GelSight-lab/GraspEveryThing/hardware/fingers/aloha/one_finger_tactile/one_finger_front_casing.STEP

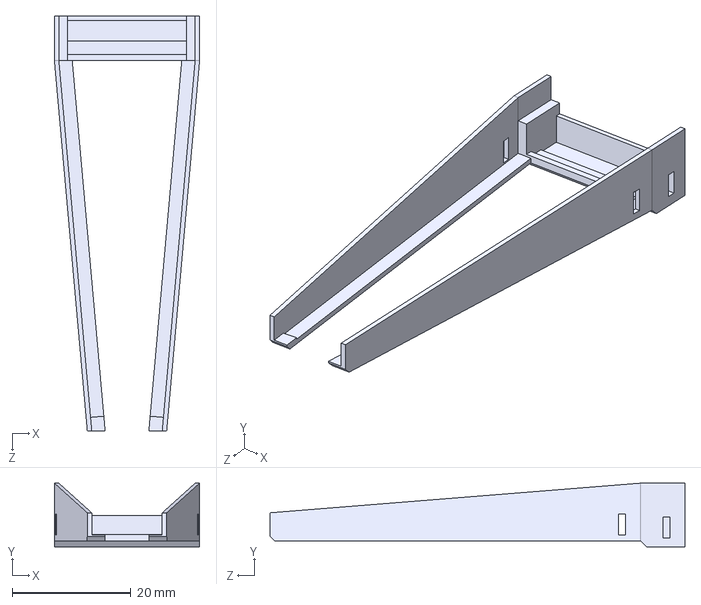
[picture p9: CAD file, 2025-05-14]
hardware/fingers/aloha/one_finger_tactile/one_finger_front_casing.STEP
24.5 x 10.7 x 70.0 mm
