GelSight-lab/GraspEveryThing/hardware/fingers/aloha/two_finger/two_finger.STEP

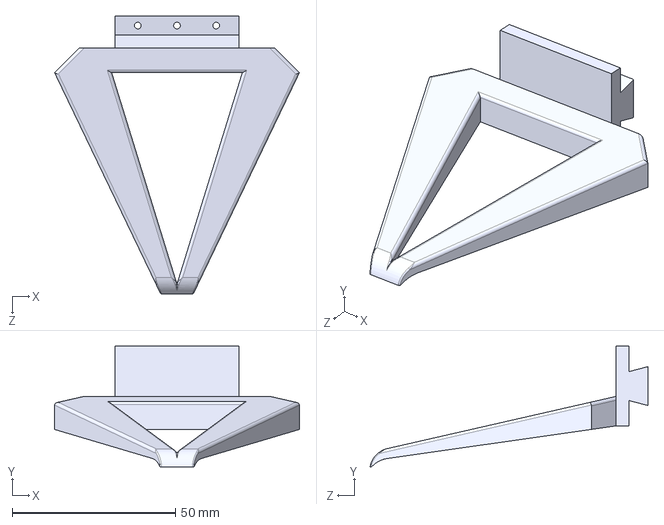
[picture p10: CAD file, 2025-05-14]
hardware/fingers/aloha/two_finger/two_finger.STEP
75.0 x 36.9 x 85.1 mm
