GelSight-lab/GraspEveryThing/hardware/fingers/panda/one_finger_no_tactile/one_finger_backing.STEP

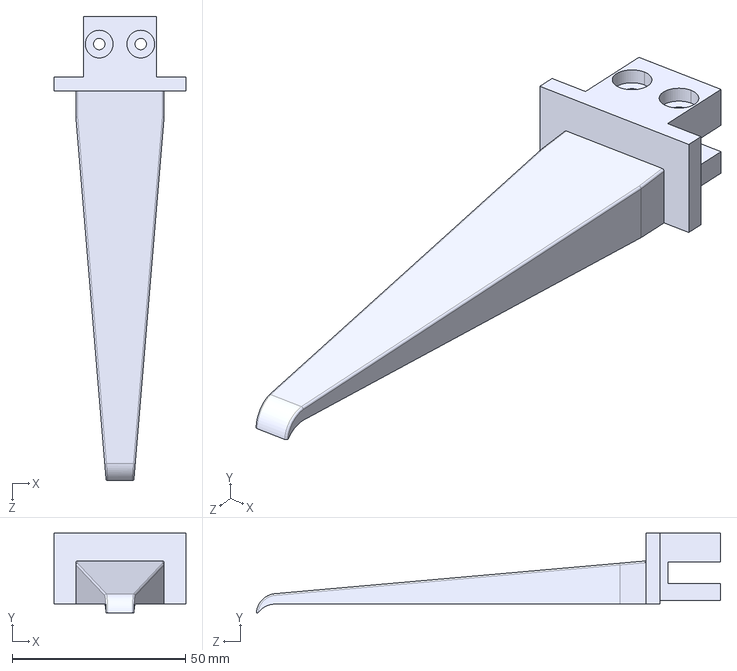
[picture p11: CAD file, 2025-05-14]
hardware/fingers/panda/one_finger_no_tactile/one_finger_backing.STEP
38.1 x 23.0 x 134.0 mm
