GelSight-lab/GraspEveryThing/hardware/fingers/panda/one_finger_tactile/one_finger_camera_stalk.STEP

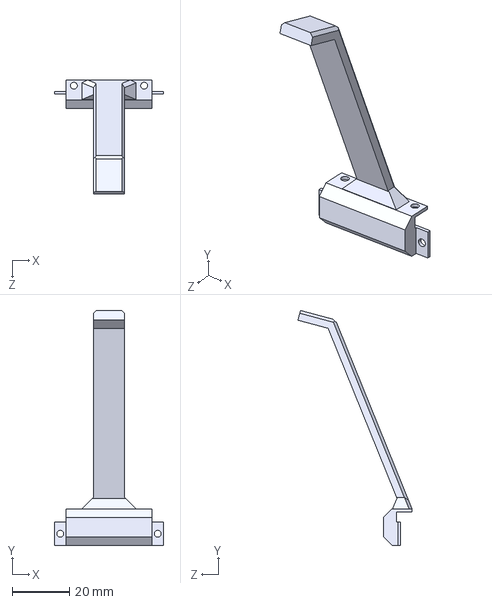
[picture p12: CAD file, 2025-05-14]
hardware/fingers/panda/one_finger_tactile/one_finger_camera_stalk.STEP
38.1 x 82.0 x 39.8 mm
