GelSight-lab/GraspEveryThing/hardware/fingers/panda/two_finger/two_finger_backing.STEP

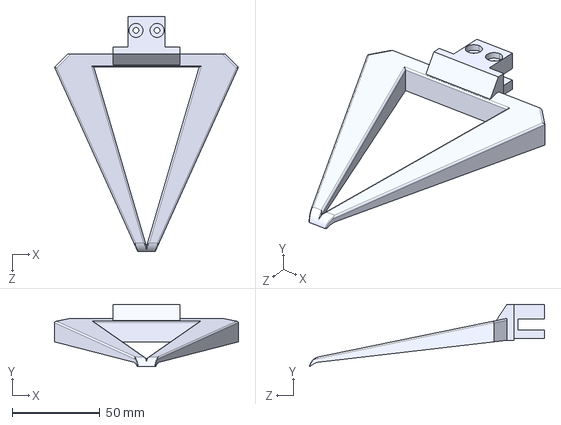
[picture p13: CAD file, 2025-05-14]
hardware/fingers/panda/two_finger/two_finger_backing.STEP
105.0 x 35.5 x 134.3 mm
