GelSight-lab/GraspEveryThing/hardware/fingers/umi/one_finger.SLDPRT

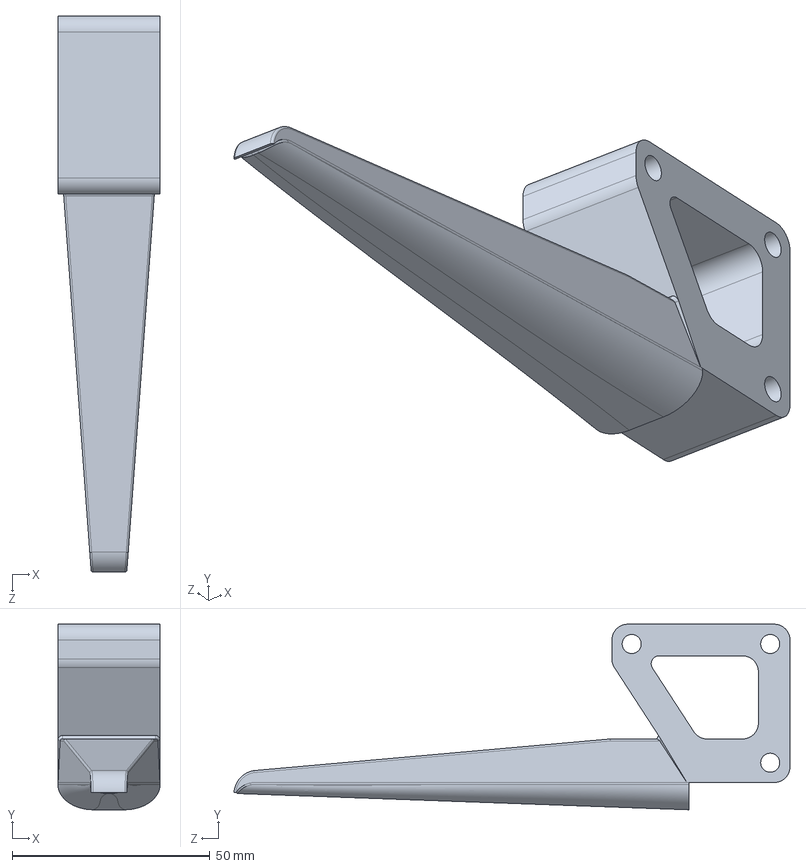
[picture p14: CAD file, 2025-05-14]
hardware/fingers/umi/one_finger.SLDPRT
25.8 x 46.9 x 140.5 mm
