GelSight-lab/GraspEveryThing/hardware/fingers_without_gel/aloha/two_finger.SLDPRT

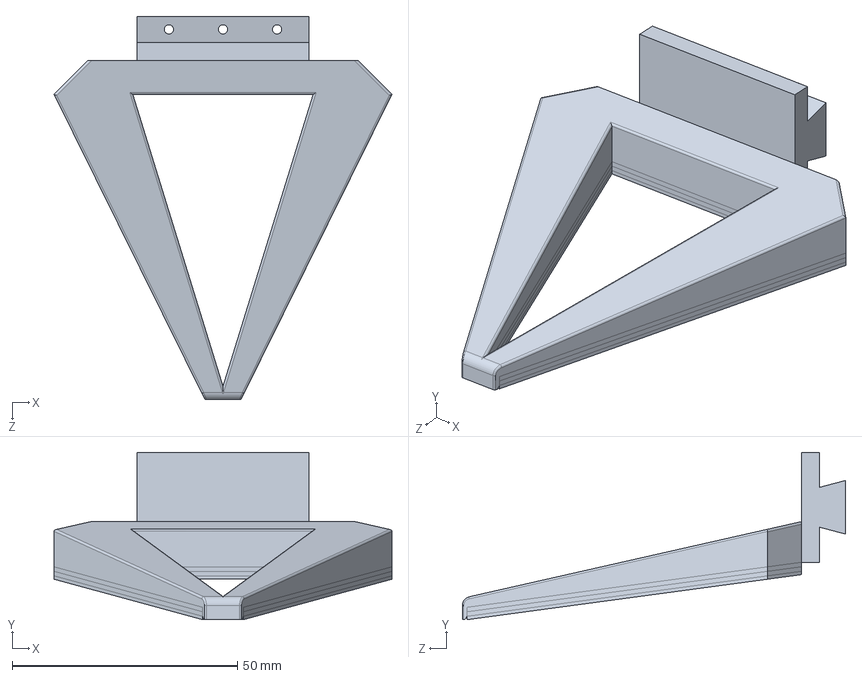
[picture p15: CAD file, 2025-05-14]
hardware/fingers_without_gel/aloha/two_finger.SLDPRT
75.0 x 37.2 x 85.1 mm
