GelSight-lab/GraspEveryThing/hardware/fingers_without_gel/panda/one_finger_backing.STEP

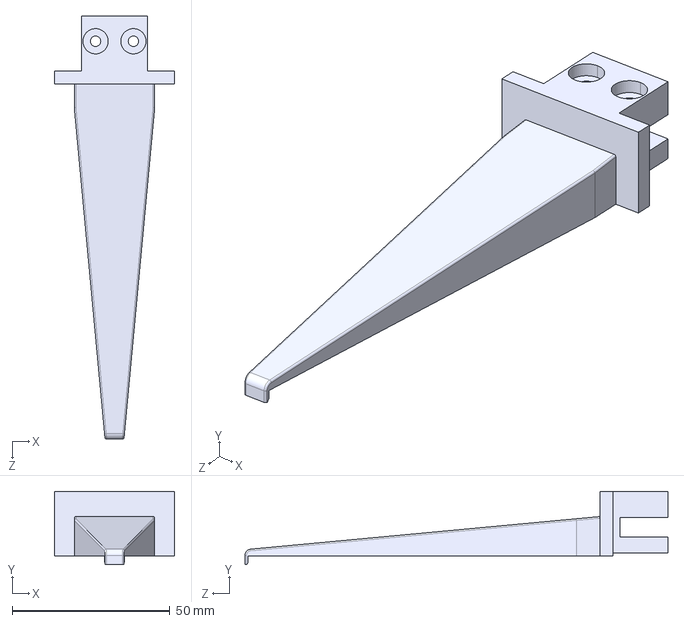
[picture p16: CAD file, 2025-05-14]
hardware/fingers_without_gel/panda/one_finger_backing.STEP
38.1 x 23.3 x 134.0 mm
