GelSight-lab/GraspEveryThing/hardware/fingers_without_gel/umi/two_finger_backing.STEP

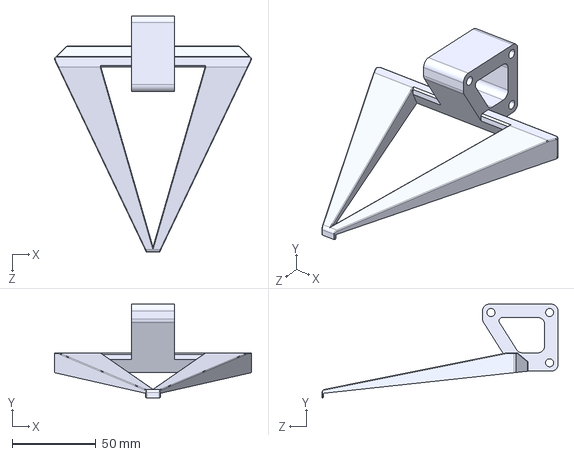
[picture p17: CAD file, 2025-05-14]
hardware/fingers_without_gel/umi/two_finger_backing.STEP
117.6 x 55.9 x 140.7 mm
