GelSight-lab/GraspEveryThing/hardware/force_probe/indenter_adapter.STEP

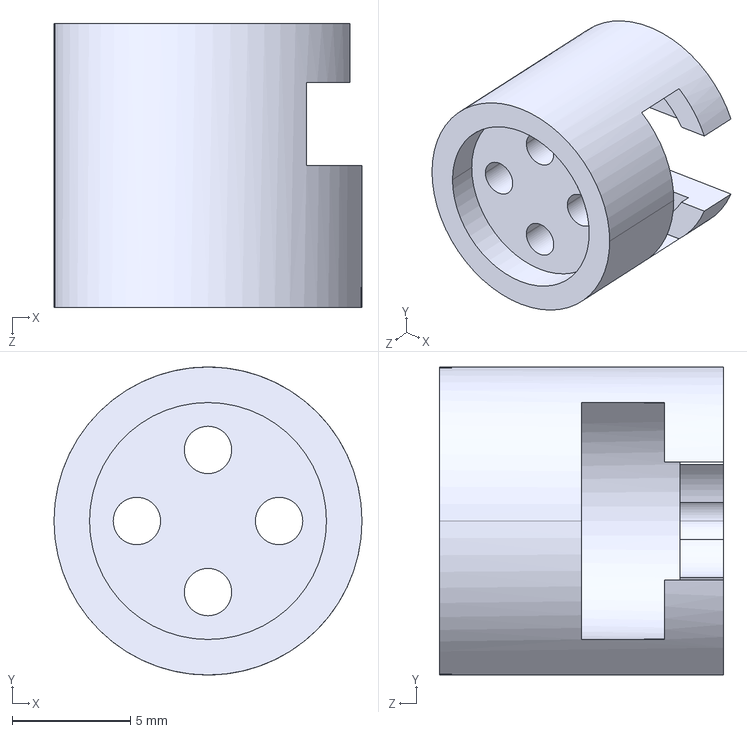
[picture p18: CAD file, 2025-05-14]
hardware/force_probe/indenter_adapter.STEP
13.0 x 13.0 x 12.0 mm
