GelSight-lab/GraspEveryThing/hardware/force_probe/indenters/cone.STEP

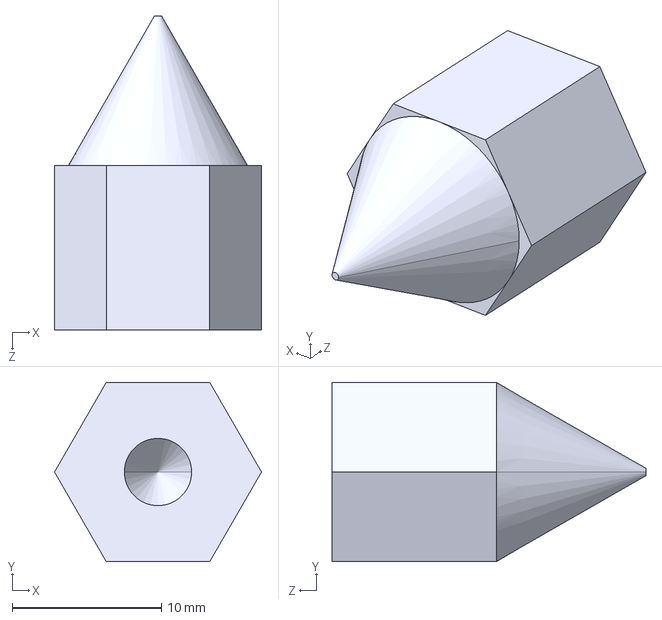
[picture p19: CAD file, 2025-05-14]
hardware/force_probe/indenters/cone.STEP
13.9 x 12.0 x 21.0 mm
