GelSight-lab/GraspEveryThing/hardware/fingers/aloha/one_finger_no_tactile/one_finger.SLDPRT

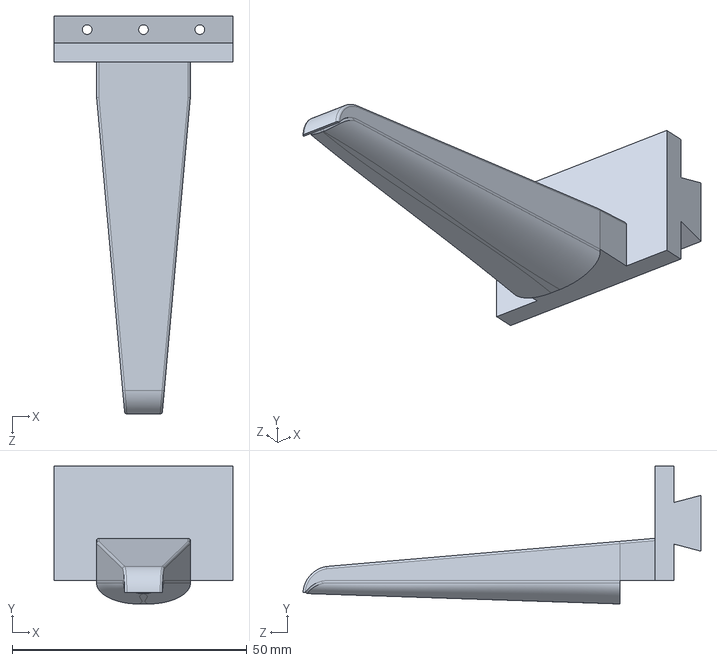
[picture p20: CAD file, 2025-05-14]
hardware/fingers/aloha/one_finger_no_tactile/one_finger.SLDPRT
38.1 x 29.4 x 84.8 mm
