GelSight-lab/GraspEveryThing/hardware/fingers/aloha/one_finger_tactile/one_finger_backing.STEP

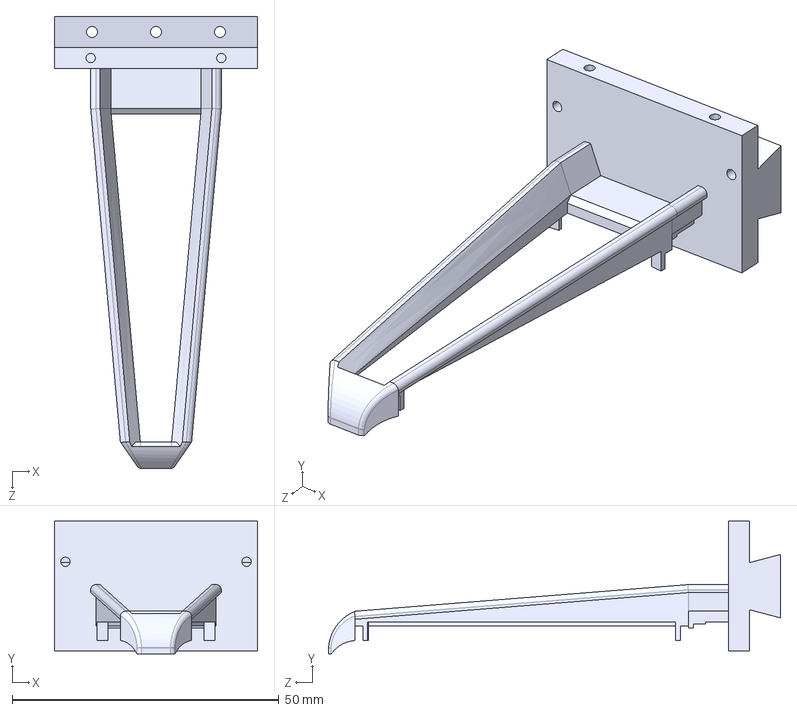
[picture p21: CAD file, 2025-05-14]
hardware/fingers/aloha/one_finger_tactile/one_finger_backing.STEP
38.1 x 24.9 x 84.8 mm
