GelSight-lab/GraspEveryThing/hardware/fingers/aloha/two_finger/two_finger_gel_mold.STEP

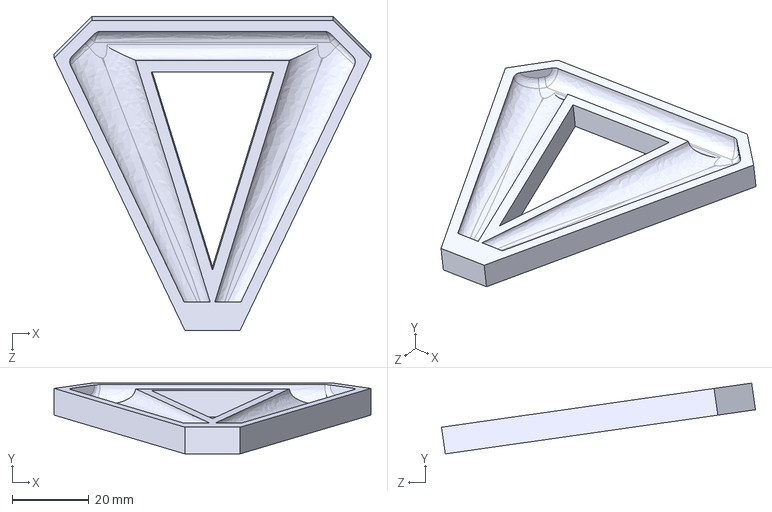
[picture p22: CAD file, 2025-05-14]
hardware/fingers/aloha/two_finger/two_finger_gel_mold.STEP
82.2 x 18.4 x 81.6 mm
