GelSight-lab/GraspEveryThing/hardware/fingers/panda/one_finger_no_tactile/one_finger_gel_mold.STEP

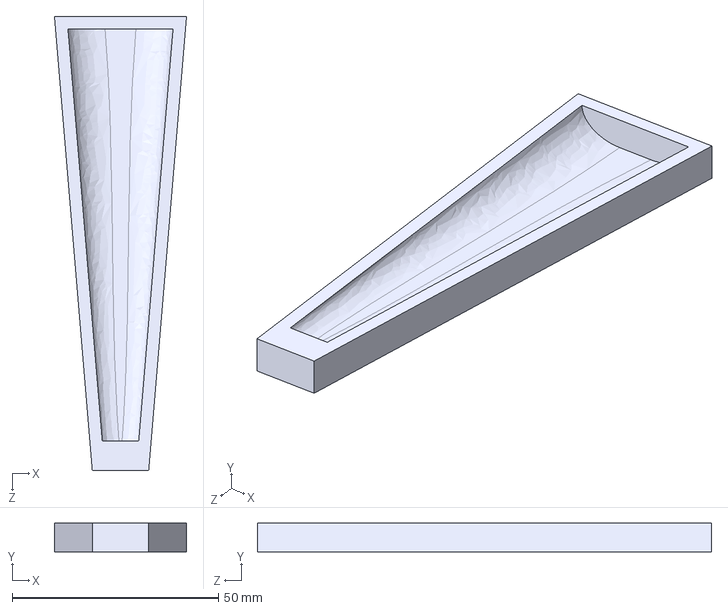
[picture p23: CAD file, 2025-05-14]
hardware/fingers/panda/one_finger_no_tactile/one_finger_gel_mold.STEP
32.0 x 7.00 x 110.1 mm
