GelSight-lab/GraspEveryThing/hardware/fingers/panda/one_finger_tactile/one_finger_gel_mold.STEP

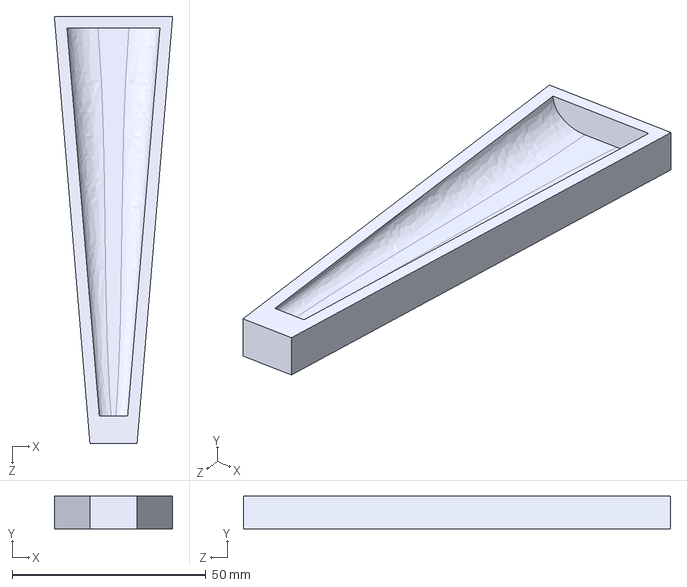
[picture p24: CAD file, 2025-05-14]
hardware/fingers/panda/one_finger_tactile/one_finger_gel_mold.STEP
30.5 x 8.50 x 110.1 mm
