GelSight-lab/GraspEveryThing/hardware/fingers/panda/two_finger/two_finger_gel_mold.STEP

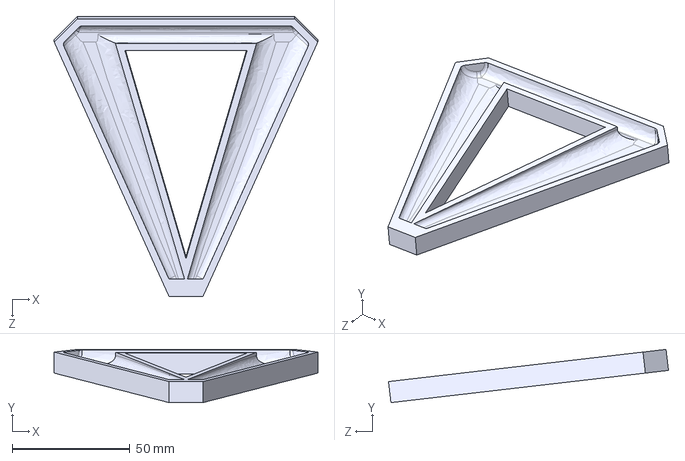
[picture p25: CAD file, 2025-05-14]
hardware/fingers/panda/two_finger/two_finger_gel_mold.STEP
112.2 x 22.6 x 119.1 mm
