GelSight-lab/GraspEveryThing/hardware/fingers/umi/two_finger.SLDPRT

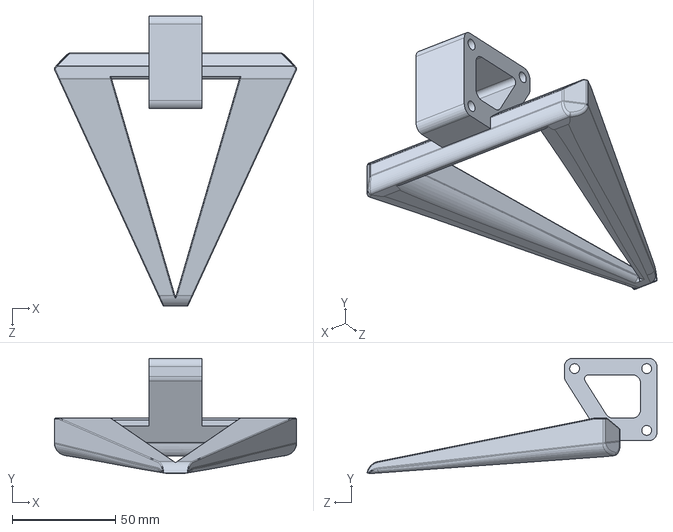
[picture p26: CAD file, 2025-05-14]
hardware/fingers/umi/two_finger.SLDPRT
117.6 x 56.0 x 140.8 mm
