GelSight-lab/GraspEveryThing/hardware/fingers_without_gel/aloha/two_finger_backing.STL

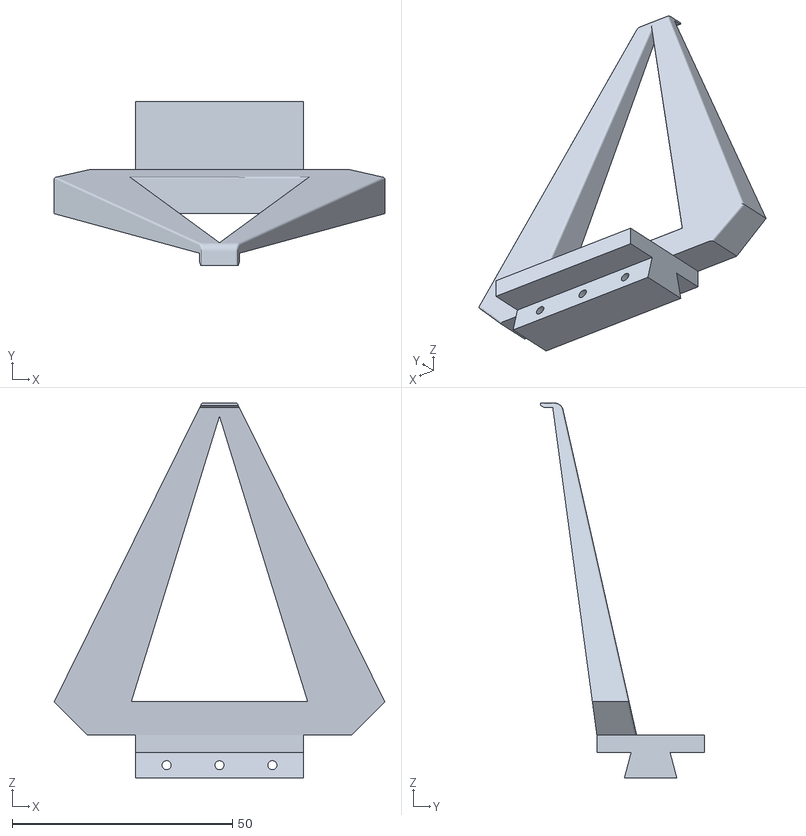
[picture p27: CAD file, 2025-05-14]
hardware/fingers_without_gel/aloha/two_finger_backing.STL
75.0 x 37.1 x 85.1
