GelSight-lab/GraspEveryThing/hardware/fingers_without_gel/umi/one_finger.SLDPRT

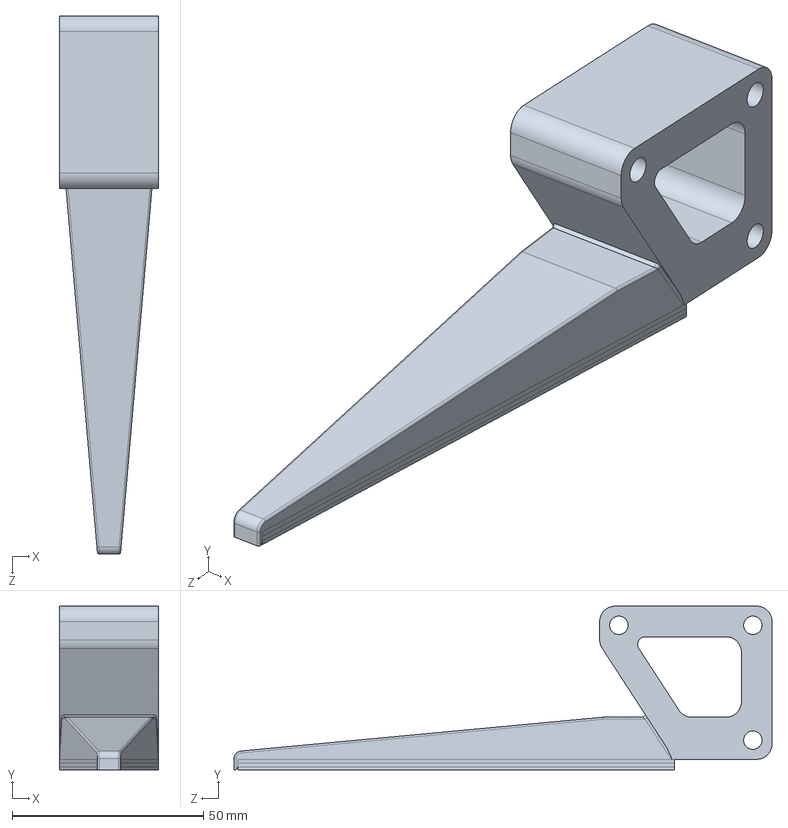
[picture p28: CAD file, 2025-05-14]
hardware/fingers_without_gel/umi/one_finger.SLDPRT
25.8 x 42.8 x 140.5 mm
