GelSight-lab/GraspEveryThing/hardware/force_probe/base.STEP

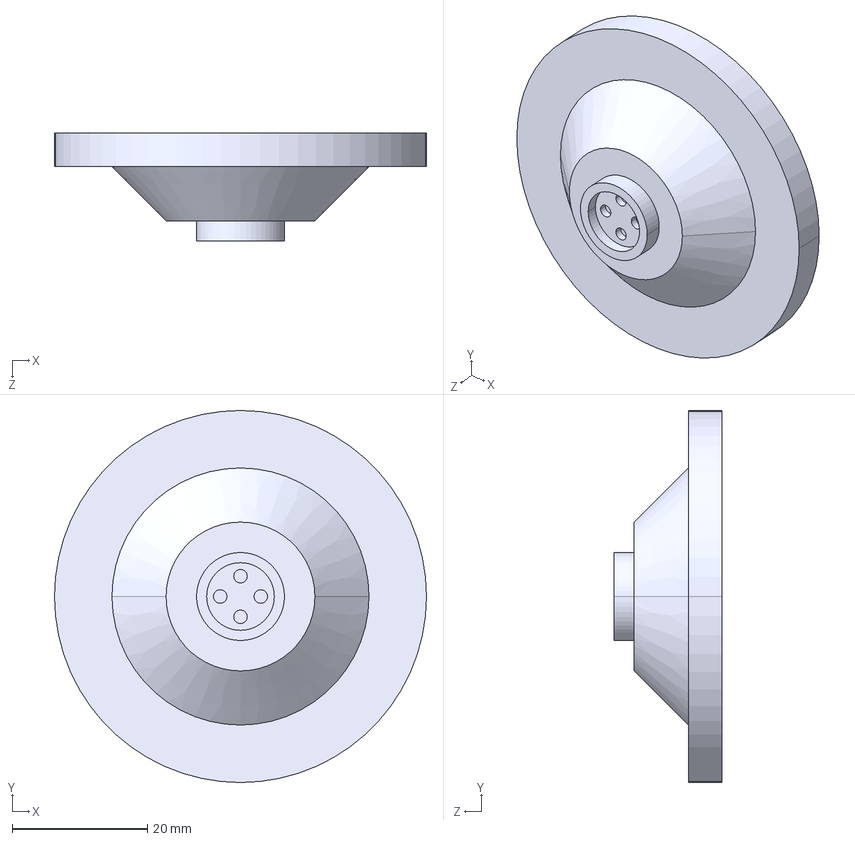
[picture p29: CAD file, 2025-05-14]
hardware/force_probe/base.STEP
55.0 x 55.0 x 16.0 mm
