GelSight-lab/GraspEveryThing/hardware/force_probe/indenters/sphere.STEP

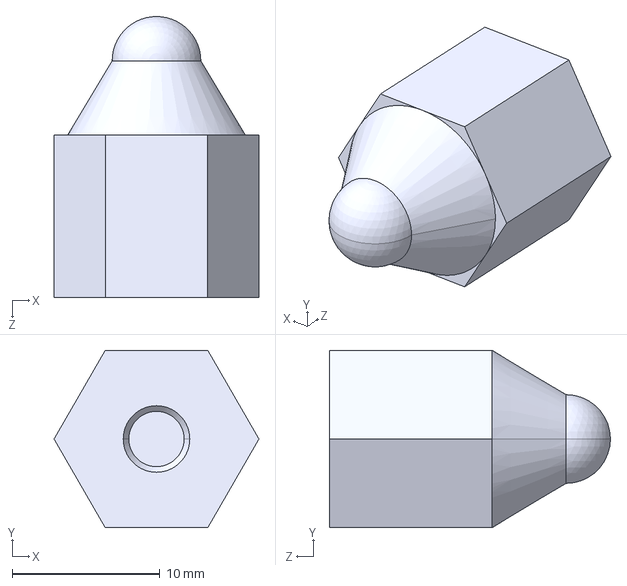
[picture p30: CAD file, 2025-05-14]
hardware/force_probe/indenters/sphere.STEP
13.9 x 12.0 x 19.0 mm
