GelSight-lab/GraspEveryThing/hardware/fingers/aloha/one_finger_no_tactile/one_finger_gel_mold.STEP

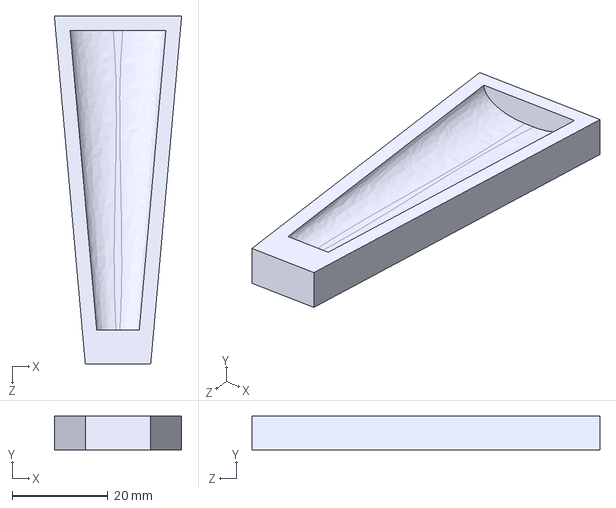
[picture p31: CAD file, 2025-05-14]
hardware/fingers/aloha/one_finger_no_tactile/one_finger_gel_mold.STEP
26.6 x 7.00 x 72.6 mm
