GelSight-lab/GraspEveryThing/hardware/fingers/aloha/one_finger_tactile/one_finger_camera_stalk.STEP

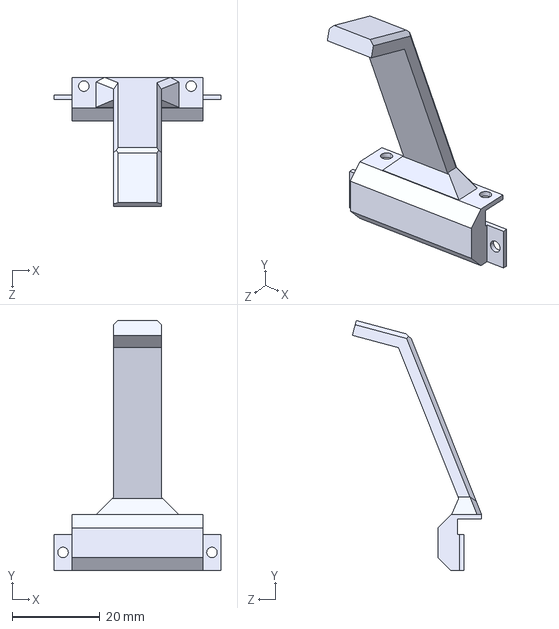
[picture p32: CAD file, 2025-05-14]
hardware/fingers/aloha/one_finger_tactile/one_finger_camera_stalk.STEP
38.1 x 57.1 x 29.5 mm
