GelSight-lab/GraspEveryThing/hardware/fingers/panda/one_finger_no_tactile/one_finger.SLDPRT

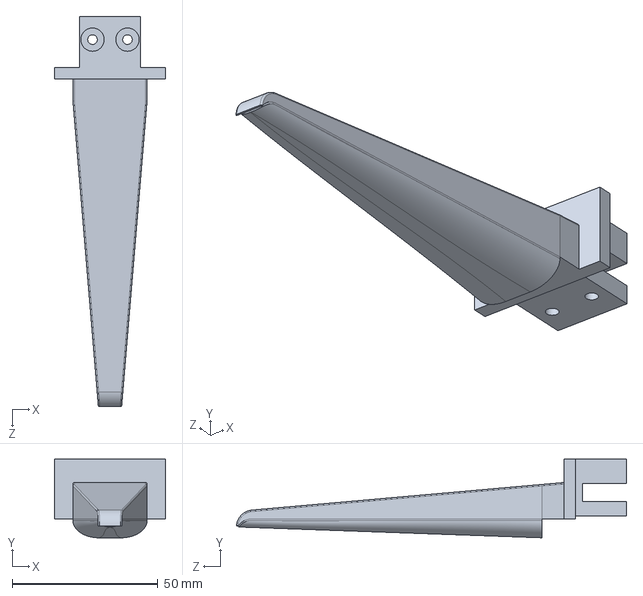
[picture p33: CAD file, 2025-05-14]
hardware/fingers/panda/one_finger_no_tactile/one_finger.SLDPRT
38.1 x 27.0 x 134.0 mm
