GelSight-lab/GraspEveryThing/hardware/fingers/panda/one_finger_tactile/one_finger_front_casing.STEP

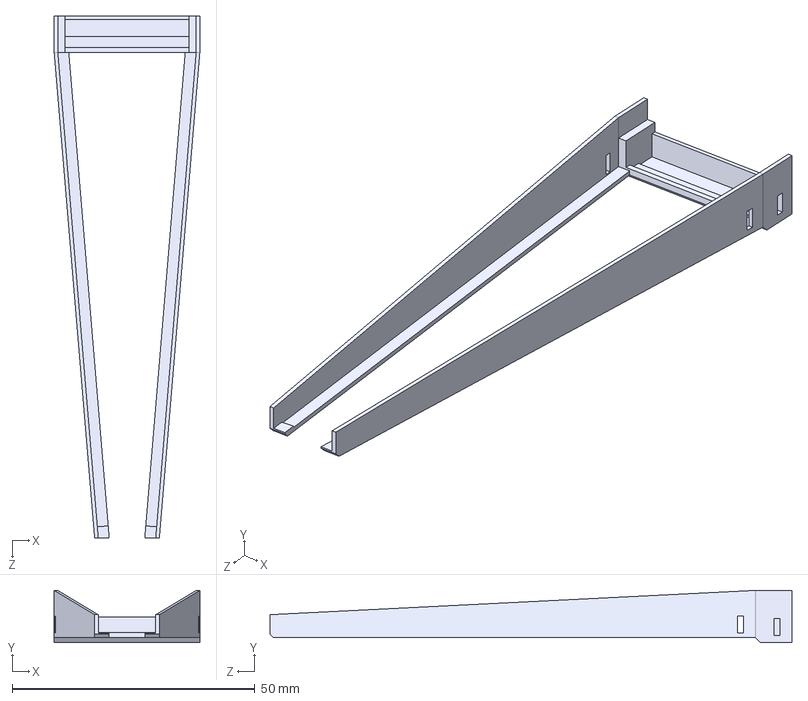
[picture p34: CAD file, 2025-05-14]
hardware/fingers/panda/one_finger_tactile/one_finger_front_casing.STEP
30.0 x 10.7 x 107.5 mm
