GelSight-lab/GraspEveryThing/hardware/fingers/panda/two_finger/two_finger.SLDPRT

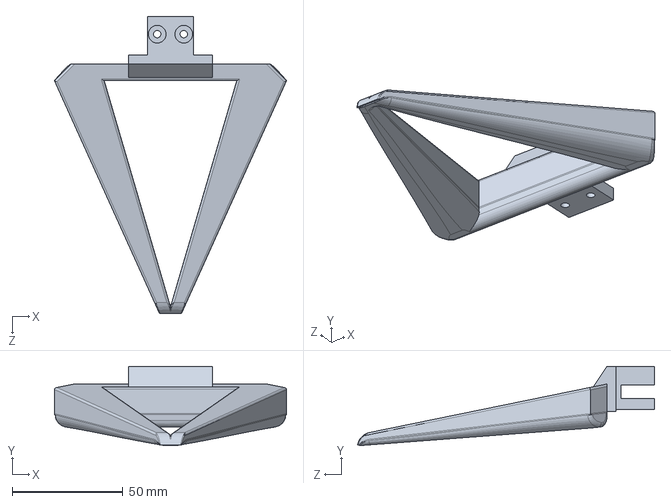
[picture p35: CAD file, 2025-05-14]
hardware/fingers/panda/two_finger/two_finger.SLDPRT
105.0 x 35.8 x 134.2 mm
