GelSight-lab/GraspEveryThing/hardware/fingers_without_gel/aloha/one_finger.SLDPRT

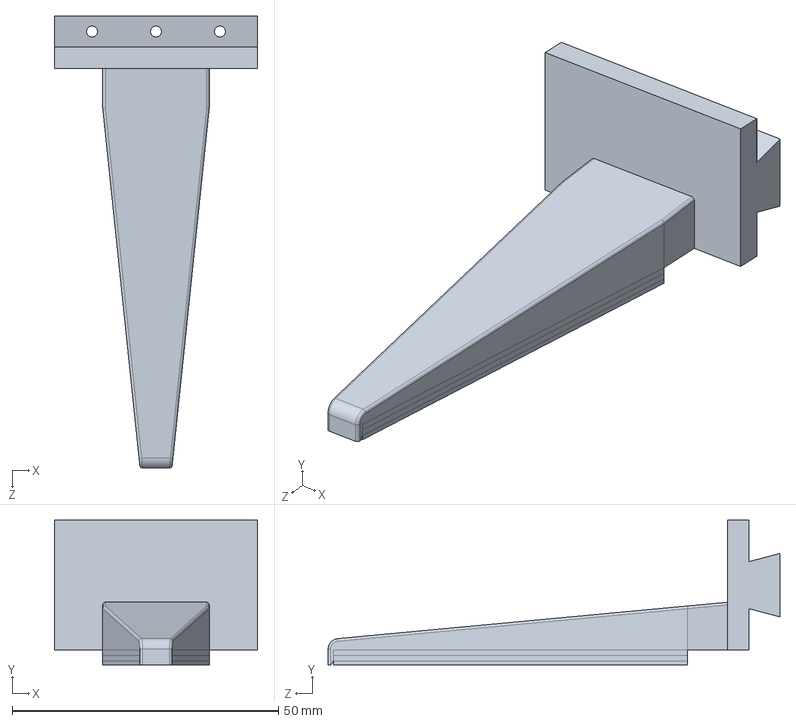
[picture p36: CAD file, 2025-05-14]
hardware/fingers_without_gel/aloha/one_finger.SLDPRT
38.1 x 27.2 x 84.8 mm
