GelSight-lab/GraspEveryThing/hardware/fingers_without_gel/panda/two_finger.SLDPRT

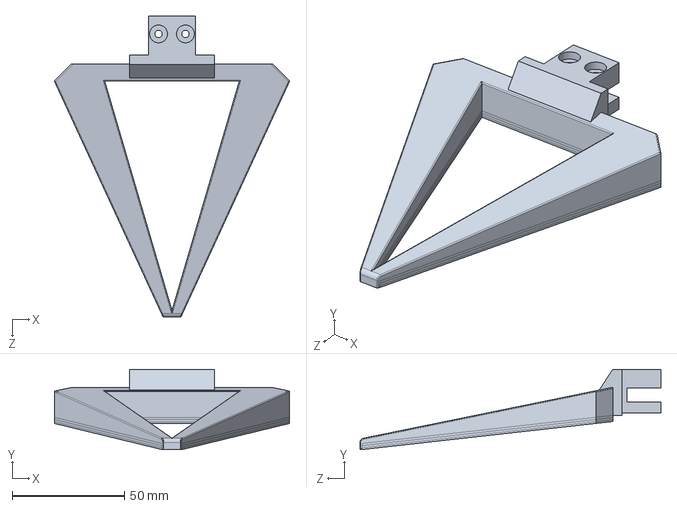
[picture p37: CAD file, 2025-05-14]
hardware/fingers_without_gel/panda/two_finger.SLDPRT
105.0 x 35.8 x 134.2 mm
