GelSight-lab/GraspEveryThing/hardware/fingers/aloha/one_finger_tactile/one_finger_gel_mold.STEP

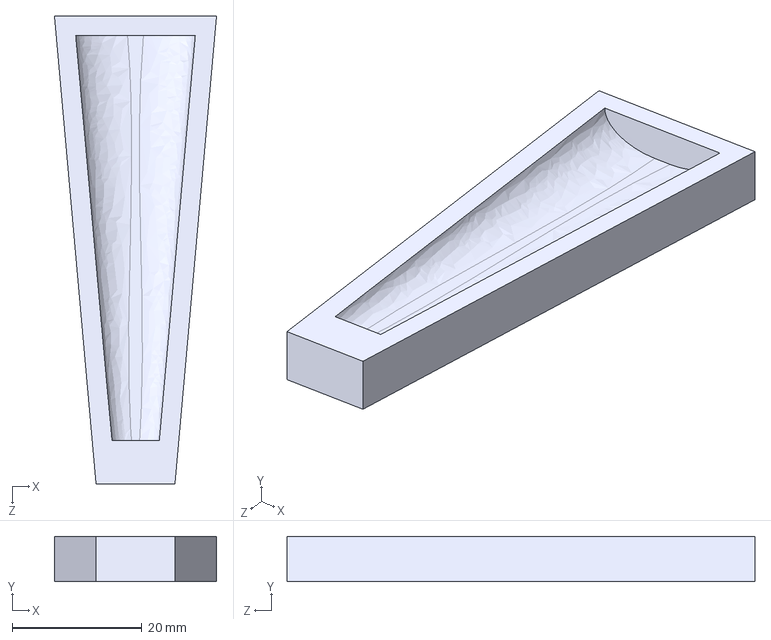
[picture p40: CAD file, 2025-05-14]
hardware/fingers/aloha/one_finger_tactile/one_finger_gel_mold.STEP
25.0 x 7.00 x 72.3 mm
