GelSight-lab/GraspEveryThing/hardware/fingers/panda/one_finger_tactile/acrylic.DXF

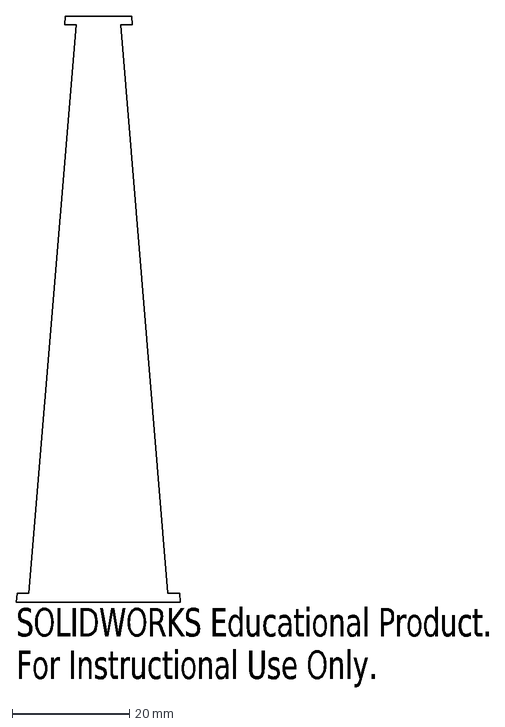
[picture p41: CAD file, 2025-05-14]
hardware/fingers/panda/one_finger_tactile/acrylic.DXF
SOLIDWORKS Educational Product.
For Instructional Use Only.
