GelSight-lab/GraspEveryThing/hardware/fingers_without_gel/aloha/one_finger_backing.STL

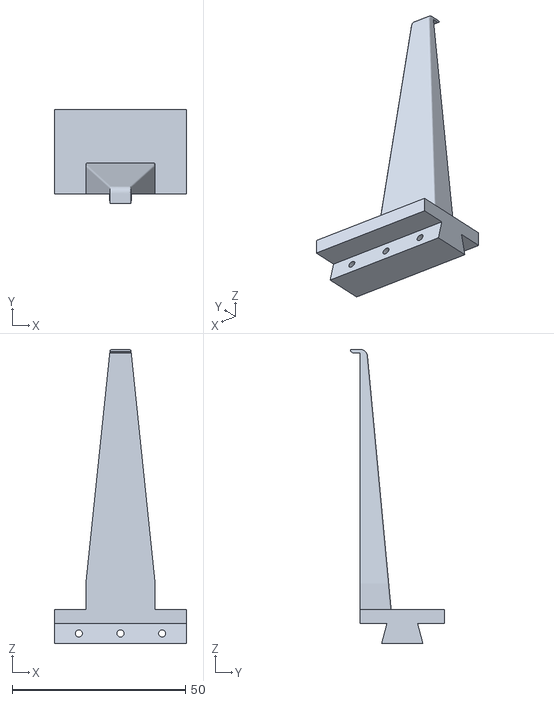
[picture p42: CAD file, 2025-05-14]
hardware/fingers_without_gel/aloha/one_finger_backing.STL
38.1 x 27.1 x 84.8
