GelSight-lab/GraspEveryThing/hardware/fingers_without_gel/panda/one_finger.SLDPRT

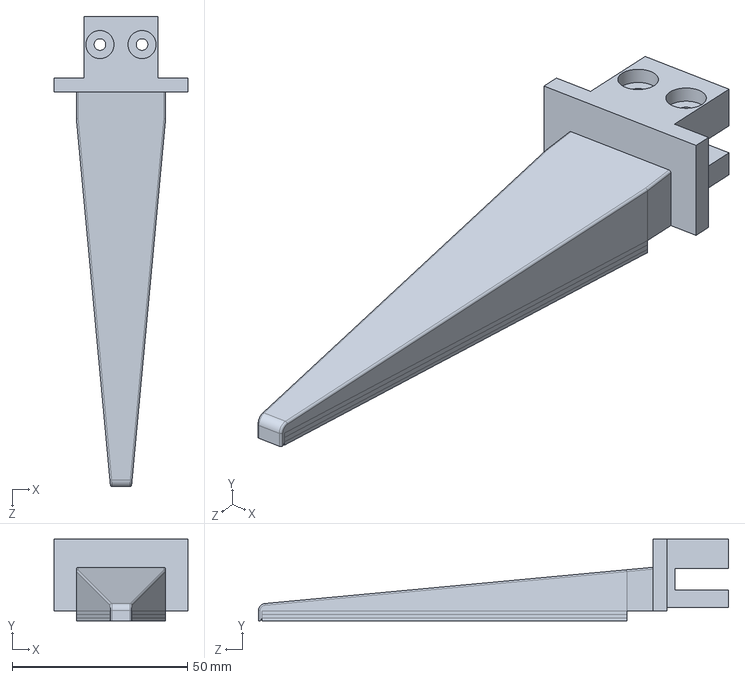
[picture p43: CAD file, 2025-05-14]
hardware/fingers_without_gel/panda/one_finger.SLDPRT
38.1 x 23.2 x 134.0 mm
