GelSight-lab/GraspEveryThing/hardware/fingers_without_gel/umi/two_finger.SLDPRT

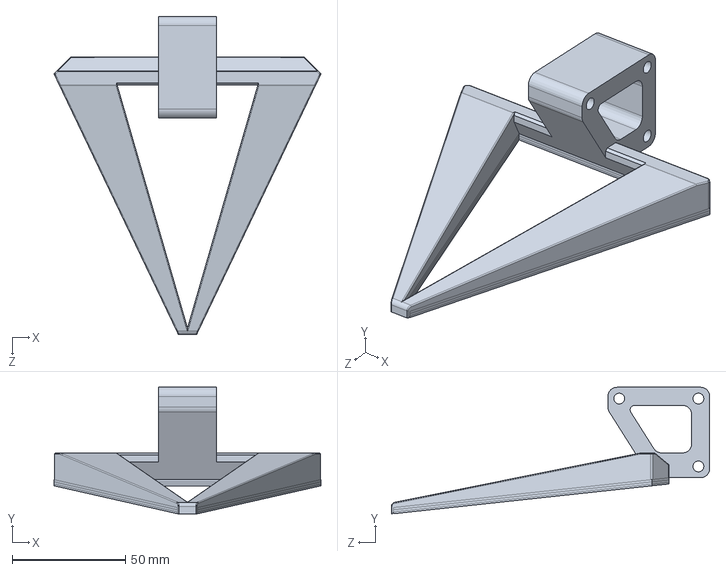
[picture p44: CAD file, 2025-05-14]
hardware/fingers_without_gel/umi/two_finger.SLDPRT
118.0 x 55.9 x 140.8 mm
