GelSight-lab/GraspEveryThing/hardware/fingers/aloha/one_finger_tactile/one_finger.SLDPRT

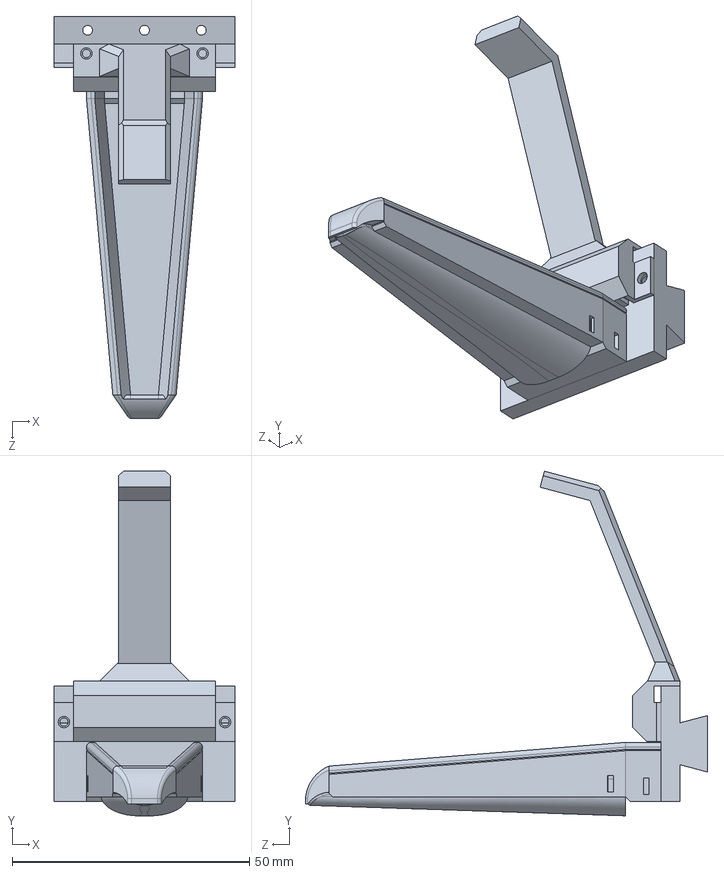
[picture p45: CAD file, 2025-05-14]
hardware/fingers/aloha/one_finger_tactile/one_finger.SLDPRT
38.1 x 72.7 x 84.8 mm
