GelSight-lab/GraspEveryThing/hardware/fingers/panda/one_finger_tactile/one_finger_backing.STEP

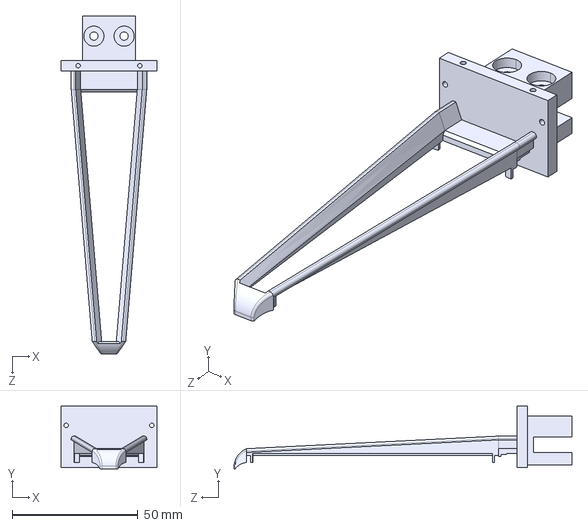
[picture p46: CAD file, 2025-05-14]
hardware/fingers/panda/one_finger_tactile/one_finger_backing.STEP
38.1 x 24.9 x 134.3 mm
