GelSight-lab/GraspEveryThing/hardware/fingers/umi/one_finger_gel_mold.STEP

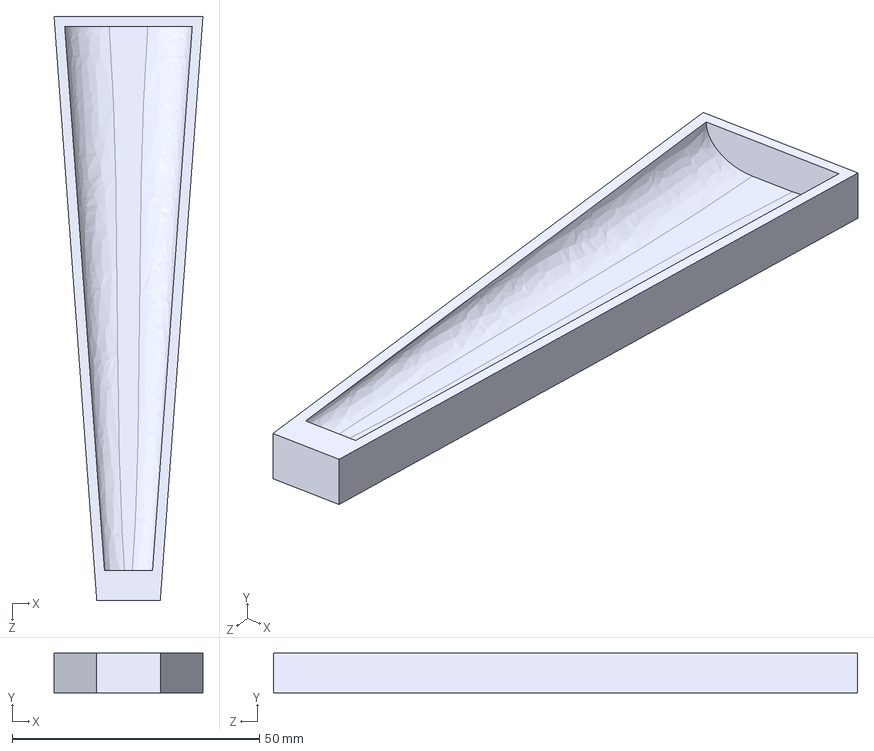
[picture p47: CAD file, 2025-05-14]
hardware/fingers/umi/one_finger_gel_mold.STEP
30.1 x 8.00 x 118.1 mm
