GelSight-lab/GraspEveryThing/hardware/fingers/aloha/one_finger_tactile/acrylic.DXF

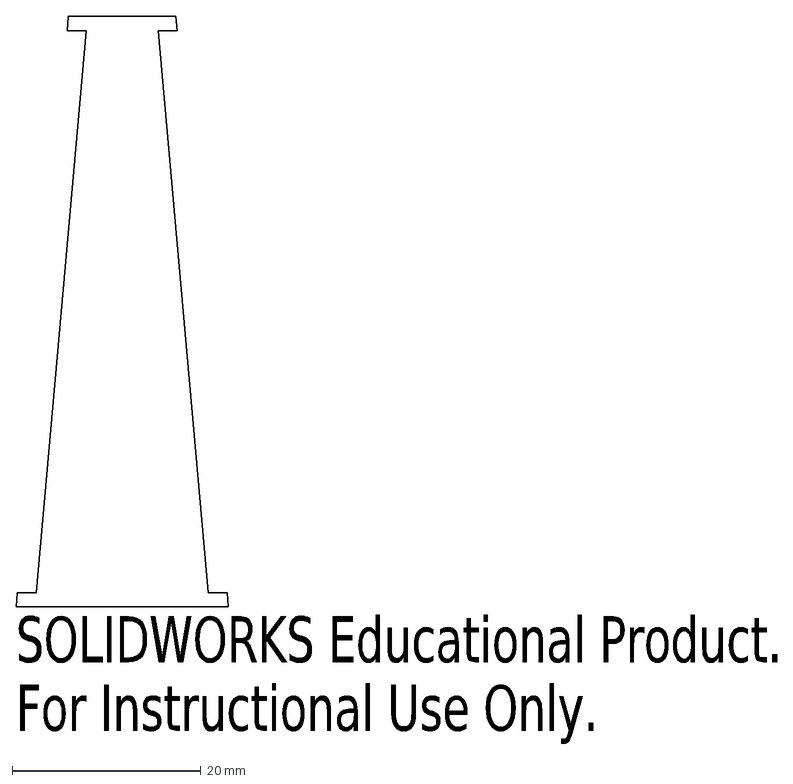
[picture p48: CAD file, 2025-05-14]
hardware/fingers/aloha/one_finger_tactile/acrylic.DXF
SOLIDWORKS Educational Product.
For Instructional Use Only.
