GelSight-lab/GraspEveryThing/hardware/fingers/panda/one_finger_tactile/one_finger.SLDPRT

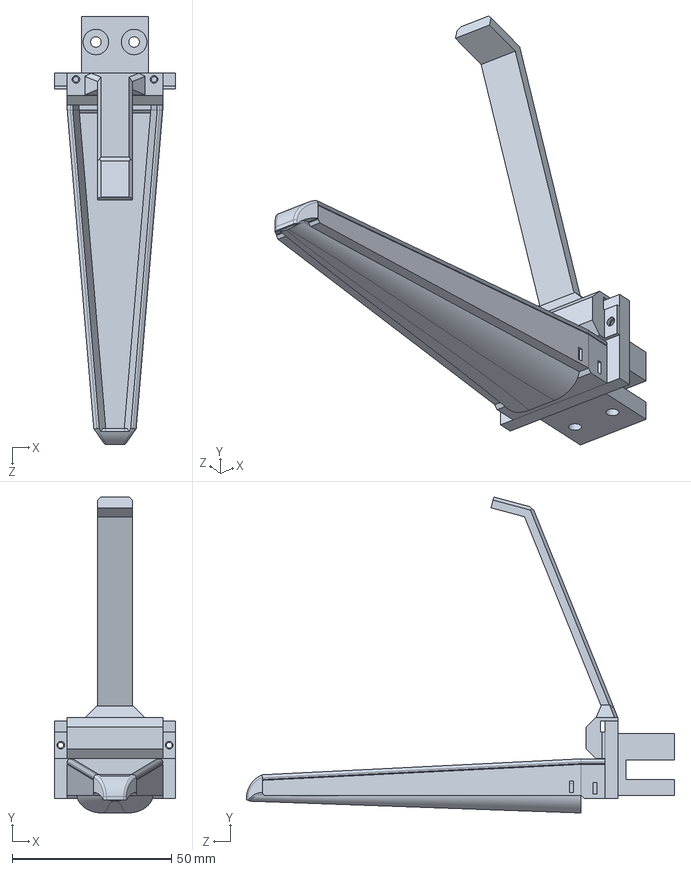
[picture p49: CAD file, 2025-05-14]
hardware/fingers/panda/one_finger_tactile/one_finger.SLDPRT
38.1 x 99.1 x 134.2 mm
