GelSight-lab/GraspEveryThing/hardware/fingers/umi/two_finger_gel_mold.STEP

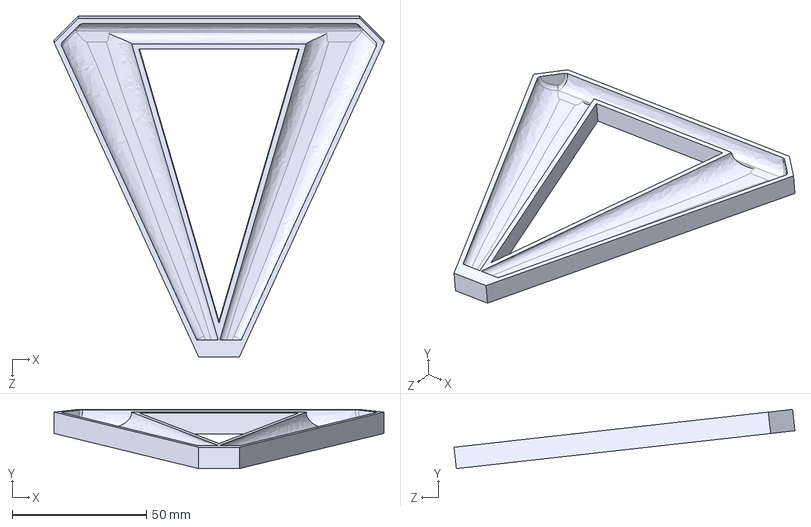
[picture p50: CAD file, 2025-05-14]
hardware/fingers/umi/two_finger_gel_mold.STEP
122.8 x 22.1 x 127.0 mm
