GelSight-lab/GraspEveryThing/(list of files, cad)

Other CAD files:
hardware/fingers_without_gel/panda/two_finger_backing.STEP
hardware/fingers/umi/two_finger_backing.STEP
hardware/fingers/umi/one_finger_backing.STEP
hardware/fingers/aloha/one_finger_no_tactile/one_finger_backing.STL
hardware/fingers/aloha/one_finger_no_tactile/one_finger_gel_mold.SLDPRT
hardware/fingers/aloha/one_finger_no_tactile/one_finger_gel_mold.STL
hardware/fingers/aloha/one_finger_tactile/one_finger_backing.STL
hardware/fingers/aloha/one_finger_tactile/one_finger_camera_stalk.STL
hardware/fingers/aloha/one_finger_tactile/one_finger_front_casing.STL
hardware/fingers/aloha/one_finger_tactile/one_finger_gel_mold.SLDPRT
hardware/fingers/aloha/one_finger_tactile/one_finger_gel_mold.STL
hardware/fingers/aloha/two_finger/two_finger.SLDPRT
hardware/fingers/aloha/two_finger/two_finger.STL
hardware/fingers/aloha/two_finger/two_finger_gel_mold.SLDPRT
hardware/fingers/aloha/two_finger/two_finger_gel_mold.STL
hardware/fingers/panda/one_finger_no_tactile/one_finger_backing.STL
hardware/fingers/panda/one_finger_no_tactile/one_finger_gel_mold.SLDPRT
hardware/fingers/panda/one_finger_no_tactile/one_finger_gel_mold.STL
hardware/fingers/panda/one_finger_tactile/one_finger_backing.STL
hardware/fingers/panda/one_finger_tactile/one_finger_camera_stalk.STL
hardware/fingers/panda/one_finger_tactile/one_finger_front_casing.STL
hardware/fingers/panda/one_finger_tactile/one_finger_gel_mold.SLDPRT
hardware/fingers/panda/one_finger_tactile/one_finger_gel_mold.STL
hardware/fingers/panda/two_finger/two_finger_backing.STL
hardware/fingers/panda/two_finger/two_finger_gel_mold.SLDPRT
hardware/fingers/panda/two_finger/two_finger_gel_mold.STL
hardware/fingers/umi/one_finger_backing.STL
hardware/fingers/umi/one_finger_gel_mold.SLDPRT
hardware/fingers/umi/one_finger_gel_mold.STL
hardware/fingers/umi/two_finger_backing.STL
hardware/fingers/umi/two_finger_gel_mold.SLDPRT
hardware/fingers/umi/two_finger_gel_mold.STL
hardware/fingers_without_gel/panda/one_finger_backing.STL
hardware/fingers_without_gel/panda/two_finger_backing.STL
hardware/fingers_without_gel/umi/one_finger_backing.STL
hardware/fingers_without_gel/umi/two_finger_backing.STL
hardware/force_probe/base.STL
hardware/force_probe/indenter_adapter.STL
hardware/force_probe/indenters/cone.STL
hardware/force_probe/indenters/sphere.STL
hardware/force_probe/indenters/square.STL
