GelSight-lab/GraspEveryThing/software/train.py

import torch
import cv2
import os
import numpy as np
import torch.nn as nn
import torch.optim as optim

import matplotlib.pyplot as plt

from torchvision import models
from torch.utils.data import Dataset, DataLoader
from torchvision import datasets, transforms

device = torch.device("cuda" if torch.cuda.is_available() else "cpu")

TRAIN_VAL_SPLIT = 0.2
BATCH_SIZE = 32

class ImageRegressionDataset(Dataset):
    def __init__(self, root_dir, transform=None):
        """
        Args:
            root_dir (string): Path to the dataset folder containing subfolders.
            transform (callable, optional): Optional transform to be applied on an image.
        """
        self.root_dir = root_dir
        self.transform = transform
        self.samples = []

        # Iterate over subfolders
        for subdir in os.listdir(root_dir):
            subdir_path = os.path.join(root_dir, subdir)
            if os.path.isdir(subdir_path):
                image_path = os.path.join(subdir_path, "diff.jpg")
                label_path = os.path.join(subdir_path, "F.npy")
                if os.path.exists(image_path) and os.path.exists(label_path):
                    self.samples.append((image_path, label_path))

    def __len__(self):
        return len(self.samples)

    def __getitem__(self, idx):
        img_path, label_path = self.samples[idx]
        
        # Load image efficiently
        image = cv2.imread(img_path, cv2.IMREAD_COLOR)
        image = cv2.cvtColor(image, cv2.COLOR_BGR2RGB)
        image = torch.from_numpy(image).float().div(255.0).permute(2, 0, 1)  # HWC -> CHW
        
        # Load label efficiently
        label = torch.tensor(np.load(label_path, allow_pickle=True).item(), dtype=torch.float32) / 30.0
        
        if self.transform:
            image = self.transform(image)

        return image, label

def get_dataloaders(data_dir, batch_size=BATCH_SIZE, image_size=224, num_workers=0, pin_memory=False):
    transform = transforms.Compose([
        transforms.Resize((image_size, image_size)),
        transforms.Normalize(mean=[0.485, 0.456, 0.406], std=[0.229, 0.224, 0.225])
    ])
    
    dataset = None
    for indenter_shape in os.listdir(f'{data_dir}/train'):
        if dataset is None:
            dataset = ImageRegressionDataset(f"{data_dir}/train/{indenter_shape}", transform=transform)
        else:
            dataset += ImageRegressionDataset(f"{data_dir}/train/{indenter_shape}", transform=transform)

    val_size = int(len(dataset) * TRAIN_VAL_SPLIT)
    train_dataset, val_dataset = torch.utils.data.random_split(dataset, [len(dataset) - val_size, val_size])
    
    train_loader = DataLoader(train_dataset, batch_size=batch_size, shuffle=True, num_workers=num_workers, pin_memory=pin_memory)
    val_loader = DataLoader(val_dataset, batch_size=batch_size, shuffle=False, num_workers=num_workers, pin_memory=pin_memory)
    
    return train_loader, val_loader

def train_model(data_dir, num_epochs=70, batch_size=BATCH_SIZE, learning_rate=0.001):
    train_loader, val_loader = get_dataloaders(data_dir, batch_size)
    
    criterion = nn.MSELoss()
    optimizer = optim.Adam(model.parameters(), lr=learning_rate)
    best_val_rmse = 1e10

    test_loaders = {}
    for obj_name in os.listdir(f'{data_dir}/test'):

        transform = transforms.Compose([
            transforms.Resize((224, 224)),
            transforms.Normalize(mean=[0.485, 0.456, 0.406], std=[0.229, 0.224, 0.225])
        ])
        
        dataset = ImageRegressionDataset(f"{data_dir}/test/{obj_name}", transform=transform)
        test_loaders[obj_name] = DataLoader(dataset, batch_size=32, shuffle=False, num_workers=0, pin_memory=False)
    
    for epoch in range(num_epochs):
        train_total_loss = 0
        train_total_sq_err = 0
        train_total_images = 0
        val_total_sq_err = 0
        val_total_images = 0

        model.train()
        for images, labels in train_loader:
            images, labels = images.to(device, non_blocking=True), labels.to(device, non_blocking=True)
            optimizer.zero_grad()
            
            outputs = model(images).squeeze()
            loss = criterion(outputs, labels)
            loss.backward()
            optimizer.step()
            train_total_loss += loss

            train_total_sq_err += torch.sum(torch.square(30 * (outputs - labels)))
            train_total_images += len(outputs)

        model.eval()

        with torch.no_grad():
            for images, labels in val_loader:
                images, labels = images.to(device, non_blocking=True), labels.to(device, non_blocking=True)
                val_total_sq_err += torch.sum(torch.square(30 * (outputs - labels)))
                val_total_images += len(outputs)
        
        train_loss = train_total_loss / train_total_images
        train_rmse = torch.sqrt(train_total_sq_err / train_total_images)
        val_rmse = torch.sqrt(val_total_sq_err / val_total_images)

        print(f"Epoch [{epoch+1}/{num_epochs}], Train Loss: {train_loss:.3f}, Train RMSE: {train_rmse:.3f}, Val. RMSE: {val_rmse:.3f}")

        if val_rmse < best_val_rmse:
            best_val_rmse = val_rmse
            torch.save(model.state_dict(), f'./model.pth')
            with open(f'./model.txt', 'w') as file:
                file.write(f"Epoch [{epoch+1}/{num_epochs}], Train Loss: {train_loss:.3f}, Train RMSE: {train_rmse:.3f}, Val. RMSE: {val_rmse:.3f}")
                
        for obj_name in os.listdir(f'{data_dir}/test'):

            test_total_sq_err = 0
            test_total_images = 0

            with torch.no_grad():
                for images, labels in test_loaders[obj_name]:
                    images, labels = images.to(device, non_blocking=True), labels.to(device, non_blocking=True)
                    outputs = model(images).squeeze()
                    test_total_sq_err += torch.sum(torch.square(30 * (outputs - labels)))
                    test_total_images += len(outputs)
            
            test_rmse = torch.sqrt(test_total_sq_err / test_total_images)

            print(f"{obj_name}, Test RMSE: {test_rmse:.3f}")
            
            with open(f'./{obj_name}.txt', 'w') as file:
                file.write(f"Test RMSE: {test_rmse:.3f}")


    return model

# Import ResNet18 model
model = models.resnet18(pretrained=True)
model.fc = nn.Sequential(
    nn.Linear(model.fc.in_features, 1),
    nn.Sigmoid()
)
model = torch.nn.DataParallel(model, device_ids=[0, 1])
model = model.to(device)

# Example usage
data_dir = "/home/mike/GraspEverything/data"
model = train_model(data_dir)
